parkourlrc/pcb-ddennis18--ESP32-IoT-DevBoard-9d88c510d1/report.txt

Info: Processing symbol 'C1:Capacitor_SMD:C_0805_2012Metric'.
Info: Processing symbol 'R9:Resistor_SMD:R_0805_2012Metric'.
Info: Processing symbol 'C2:Capacitor_SMD:C_0805_2012Metric'.
Info: Processing symbol 'J5:Connector_PinHeader_2.54mm:PinHeader_1x05_P2.54mm_Vertical'.
Info: Processing symbol 'C3:ESP32-IoT:T491A'.
Info: Processing symbol 'Q2:Package_TO_SOT_SMD:SOT-23'.
Info: Processing symbol 'C4:ESP32-IoT:T491A'.
Info: Processing symbol 'J6:Connector_PinHeader_2.54mm:PinHeader_1x04_P2.54mm_Vertical'.
Info: Processing symbol 'C5:Capacitor_SMD:C_0805_2012Metric'.
Info: Processing symbol 'R3:Resistor_SMD:R_0805_2012Metric'.
Info: Processing symbol 'C6:Capacitor_SMD:C_0805_2012Metric'.
Info: Processing symbol 'LED1:ESP32-IoT:LEDC2012X120N'.
Info: Processing symbol 'C7:Capacitor_SMD:C_0805_2012Metric'.
Info: Processing symbol 'Q3:Package_TO_SOT_SMD:SOT-23'.
Info: Processing symbol 'C8:ESP32-IoT:T491A'.
Info: Processing symbol 'LED2:ESP32-IoT:LEDC2012X120N'.
Info: Processing symbol 'C9:Capacitor_SMD:C_0805_2012Metric'.
Info: Processing symbol 'R5:Resistor_SMD:R_0805_2012Metric'.
Info: Processing symbol 'C10:ESP32-IoT:T491A'.
Info: Processing symbol 'LED3:ESP32-IoT:LEDC2012X120N'.
Info: Processing symbol 'C11:Capacitor_SMD:C_0805_2012Metric'.
Info: Processing symbol 'R1:Resistor_SMD:R_0805_2012Metric'.
Info: Processing symbol 'C12:Capacitor_SMD:C_0805_2012Metric'.
Info: Processing symbol 'LED4:ESP32-IoT:LEDC2012X120N'.
Info: Processing symbol 'C13:ESP32-IoT:T491A'.
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
Add U5 (footprint 'Package_TO_SOT_SMD:SOT-23-6').
Add R3 (footprint 'Resistor_SMD:R_0805_2012Metric').
Add R4 (footprint 'Resistor_SMD:R_0805_2012Metric').
Add R5 (footprint 'Resistor_SMD:R_0805_2012Metric').
Error: Cannot add U2 (footprint 'BME280:PSON65P250X250X100-8N' not found).
Error: Cannot add S2 (footprint 'USLPT2819DT2TR:SW_USLPT2819DT2TR' not found).
Error: Cannot add U3 (footprint 'ESP32-C3-WROOM-02-H4:MODULE_ESP32-C3-WROOM-02-H4' not found).
Error: Cannot add J3 (footprint 'GSD090012SEU:AMPHENOL_GSD090012SEU' not found).
Error: Cannot add U4 (footprint 'Package_DFN_QFN:SiliconLabs_QFN-20-1EP_3x3mm_P0.5mm' not found).
Error: Cannot add MK1 (footprint 'CMC-5042PF-AC:CUI_CMC-5042PF-AC' not found).
Error: Cannot add J2 (footprint 'B2B-PH-SM4-TB:JST_B2B-PH-SM4-TB' not found).
Error: Cannot add Q1 (footprint 'TEMT6000X01:TRANS_TEMT6000X01' not found).
Error: Cannot add U6 (footprint 'W25Q32JVSSIQ:SOIC127P790X216-8N' not found).
Error: Cannot add S1 (footprint 'USLPT2819DT2TR:SW_USLPT2819DT2TR' not found).
Error: Cannot add U7 (footprint 'MAX4466EXK:SOT65P210X110-5N' not found).
Error: Cannot add J1 (footprint 'SS-52400-002:BELFUSE_SS-52400-002' not found).
Error: Cannot add VR1 (footprint 'LM1117MPX-3.3:VREG_LM1117MPX-3.3' not found).

Info: Total warnings: 0, errors: 13.
